kimjonghyub/IC-706-Remote/image/wire.png

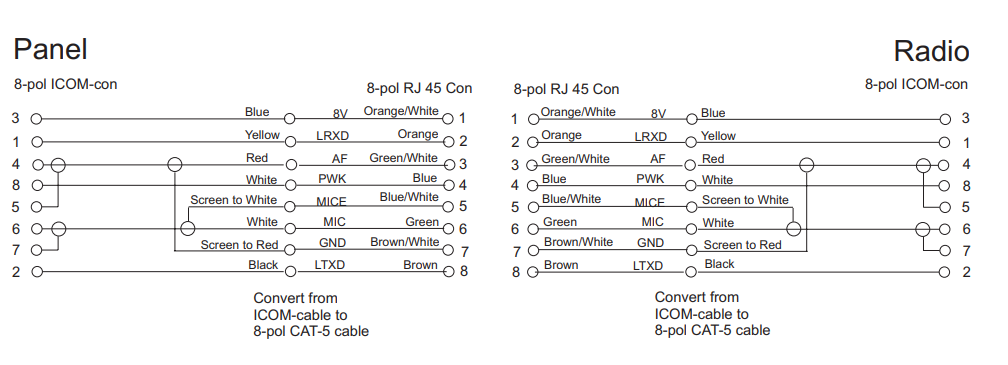
image/wire.png
