kimjonghyub/IC-706-Remote/doc/ICOM-706 cable-cat5-1a.pdf

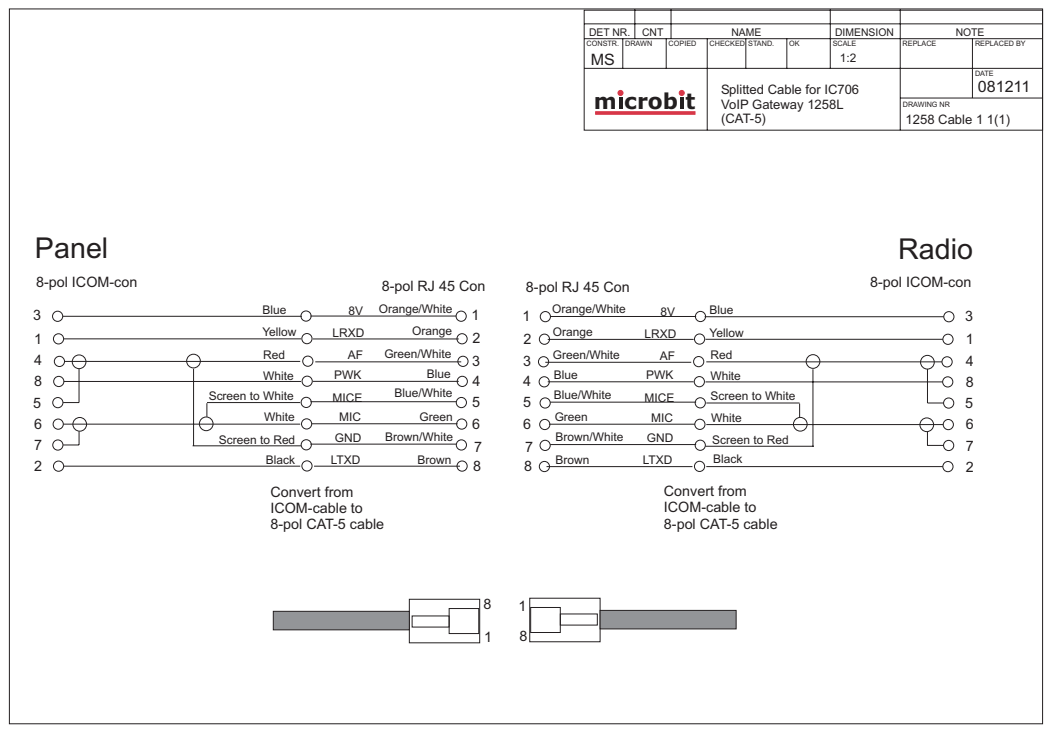
[picture p11: page 1]
DRAWING NR 1258 Cable 1 1(1); Panel; Radio; Yellow; Green/White; Blue; Black; Brown; Green; Orange; Orange/White; Red; Blue/White; Screen to Red; White; Brown/White; Screen to White; LTXD; LRXD; GND; MIC; MICE; PWK; 8-pol RJ 45 Con; 8-pol RJ 45 Con 8-pol ICOM-con; 8-pol ICOM-con

DET NR. | CNT | NAME | DIMENSION | NOTE
CONSTR. MS | DRAWN | COPIED | CHECKED | STAND. | OK | SCALE 1:2 | REPLACE | REPLACED BY

m crob t | | | Splitted Cable for IC706 VoIP Gateway 1258L (CAT-5) | | | | | DATE 081211

Convert from
ICOM-cable to
8-pol CAT-5 cable
