kimjonghyub/IC-706-Remote/doc/Schematic_ic706-remote_2024-05-09.pdf

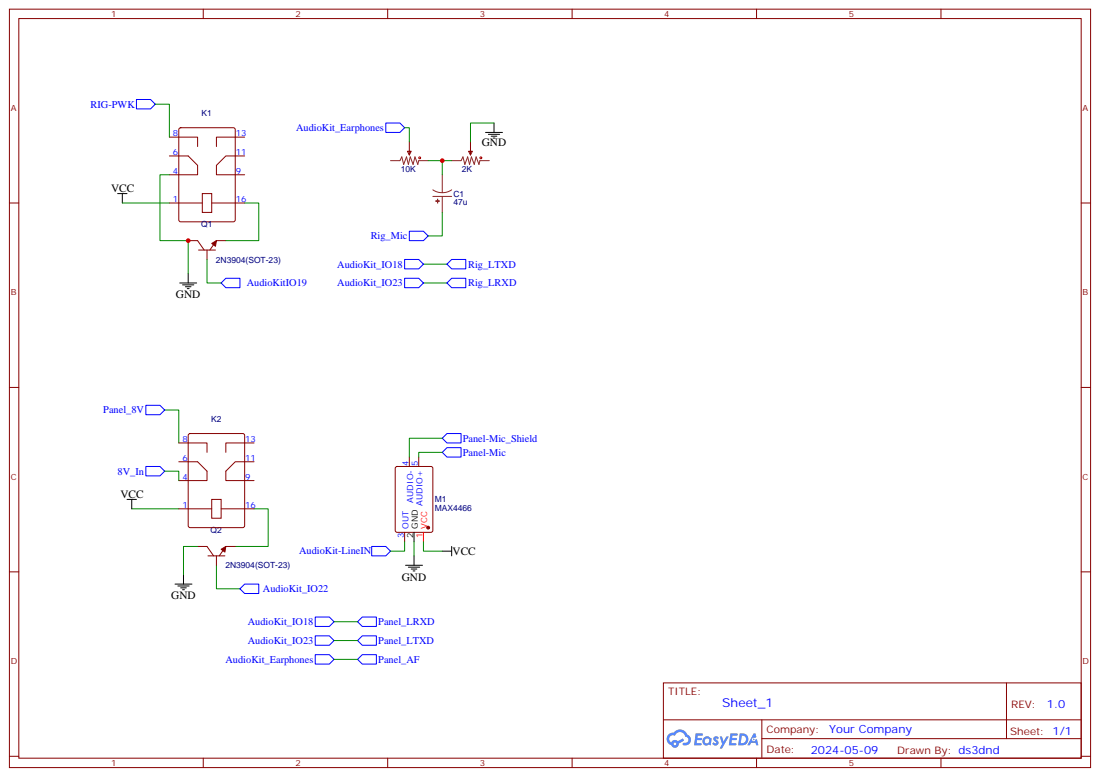
[picture p12: page 1]
